simple-circuit/minict/README.md

# minict

This repository is an archive for the N7VK Mini Curve Tracer source code. For the original version, two key components, the C8051F121-GQ micro and the DPL-USB1232H serial to USB converter are still available. However, newer processors such as the Raspberry Pi Pico2 can reduce the cost considerably with only a slight decrease in analog performance.

The pico_ct folder contains a design upgrade using the Pico2 processor. Instead of a single double sided PC board, the design has been split to two boards. Each board can be CNC milled on a single sided copper clad board. Build informaton is contained in the picoCT board build pdf document.
This is an advanced project.

.
The new curve tracer assembly.

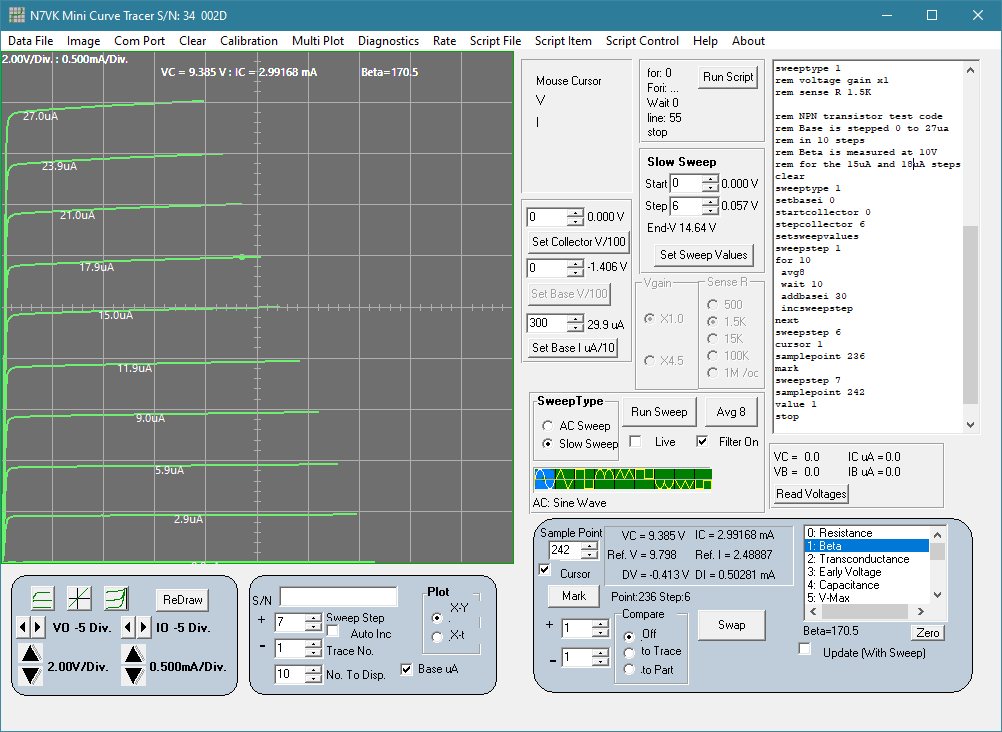
[picture p1: beta.png]
.
Curves for a 2N2222A transistor.

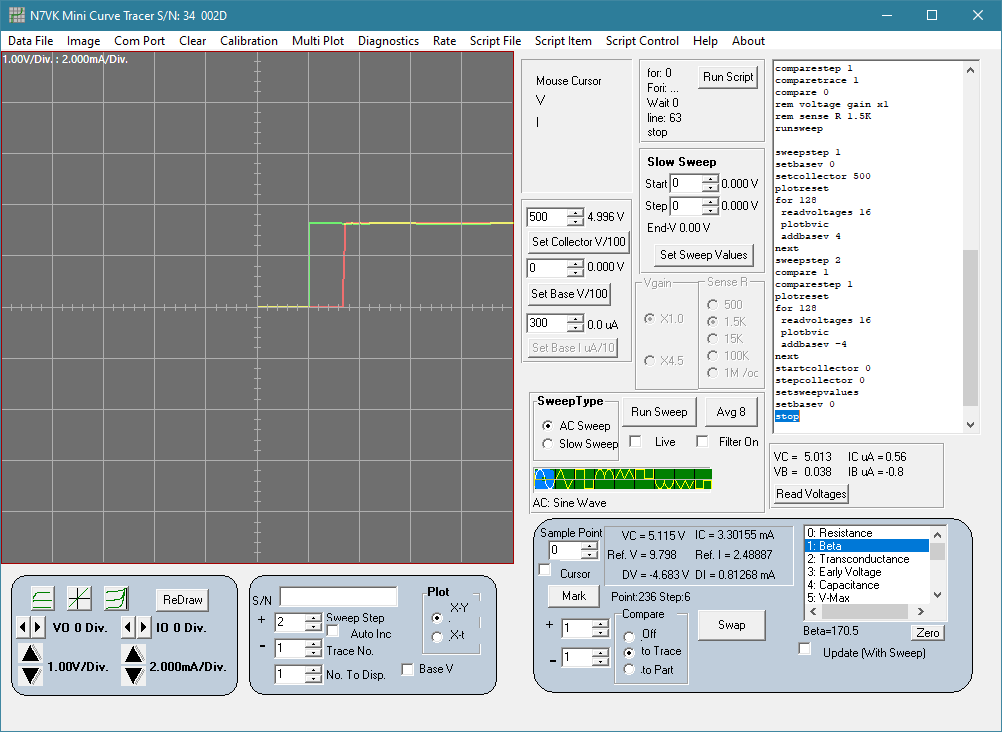
[picture p2: relay.png]
.
Hysteresis traces for a DIP relay.

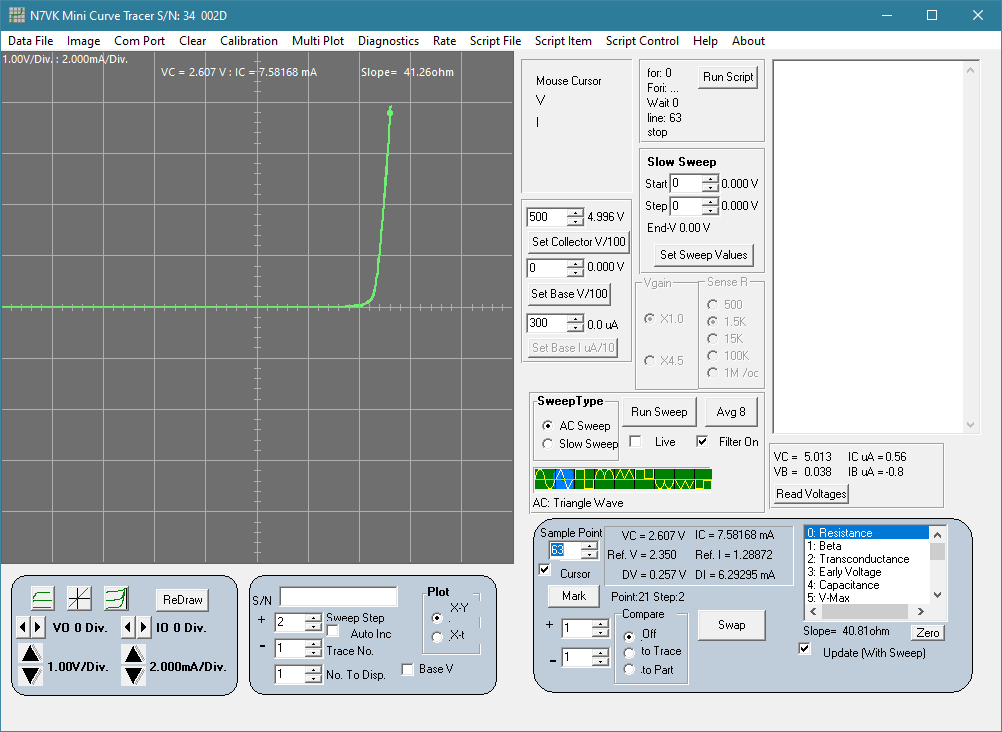
[picture p3: led.png]
.
Measuring an LED turn on voltage and series resistance.

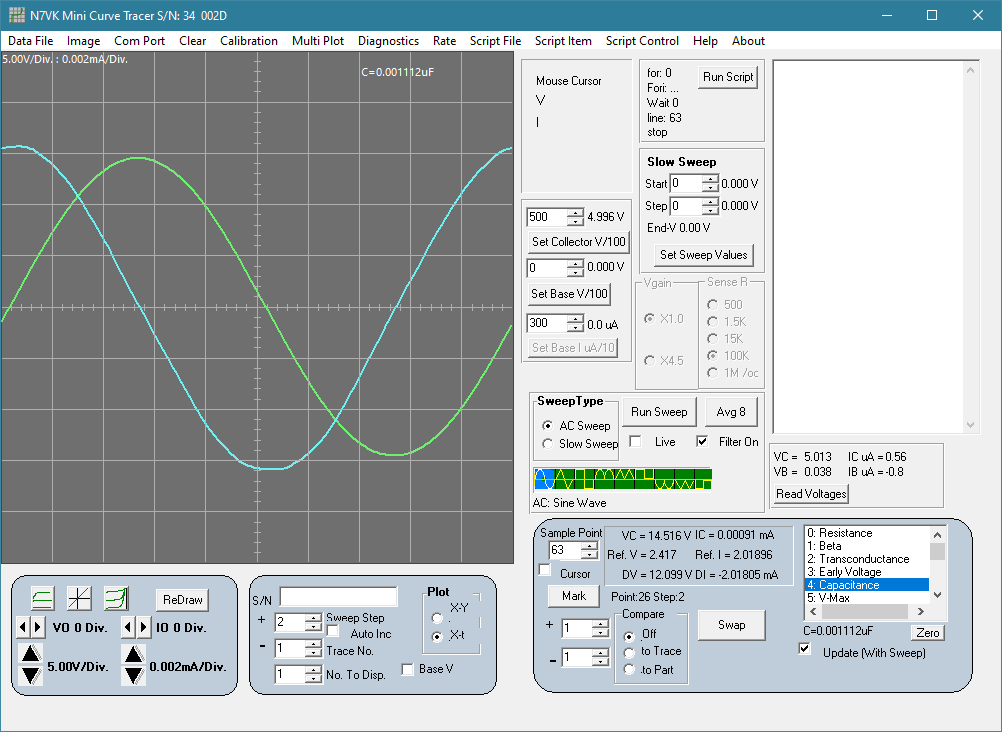
[picture p4: capacitor.png]
.
Capacitor measurement showing the current and voltage plots over time.
