simple-circuit/minict/pico_ct/readme first.pdf

# MiniCT

Three compiled version of the curve tracer application are available.

pico2_ct.exe is the Windows 64 verson

miniCT_PI_32 is the Raspberry Pi 32 bit-version

miniCT_PI_64 is the Raspberry Pi 64 bit-version

When running the Windows version, an error message may be displayed. This usually occurs when the curve tracer is not plugged into the USB port. Just click Ok to continue.

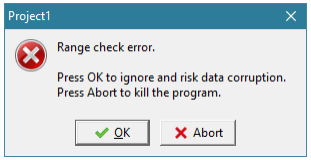
[picture p5: figure]

When the Raspberry Pi Linux executable file is copied, check the file properties and set Execute to Anyone.

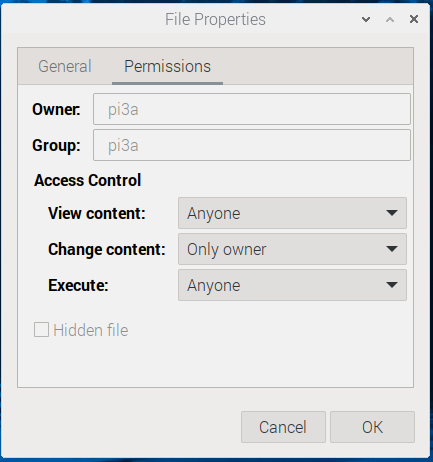
[picture p6: figure]

Double click on the file and select execute.

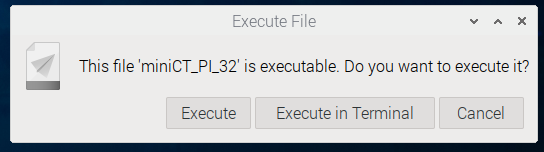
[picture p7: figure]

The program may also give an error message. This is more common in the 32-bit version. It is related to a search for an active curve tracer on the USB ports. Just click Ok.

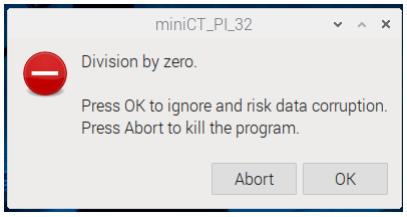
[picture p8: figure]

For Windows and Linux click on Calibrate then Load Cal to read in the calibration constants. You will need to perform a calibration procedure on your curve tracer for the most accurate measurements.

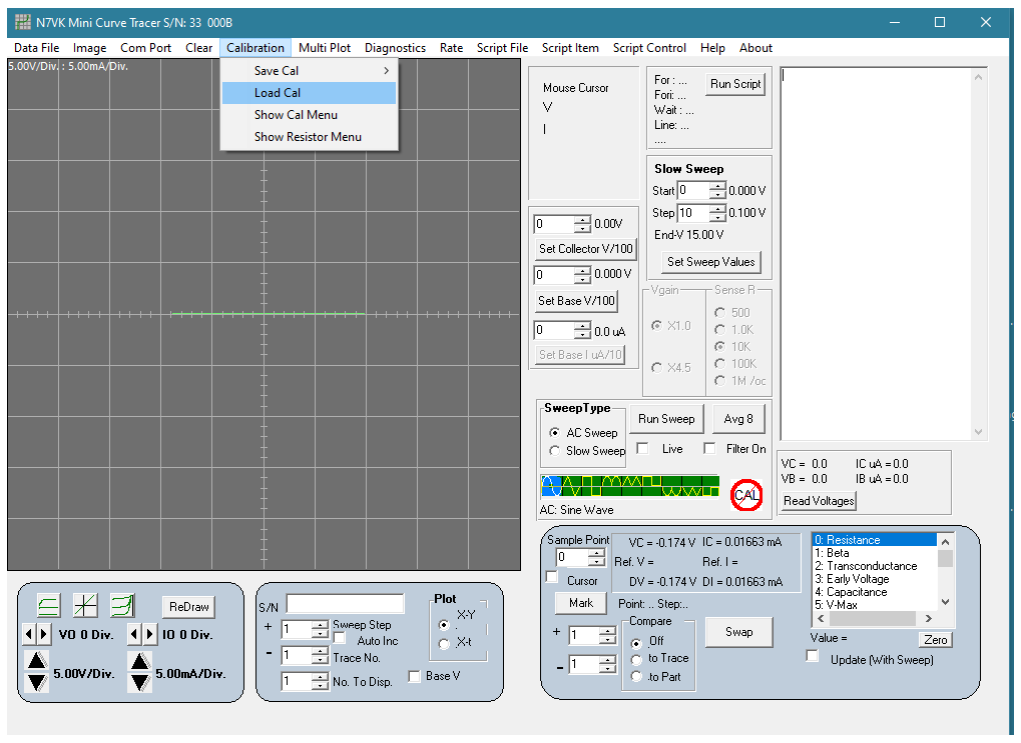
[picture p9: figure]
