simple-circuit/minict/Pascal_Code/Examples/2N2222AS.bmp

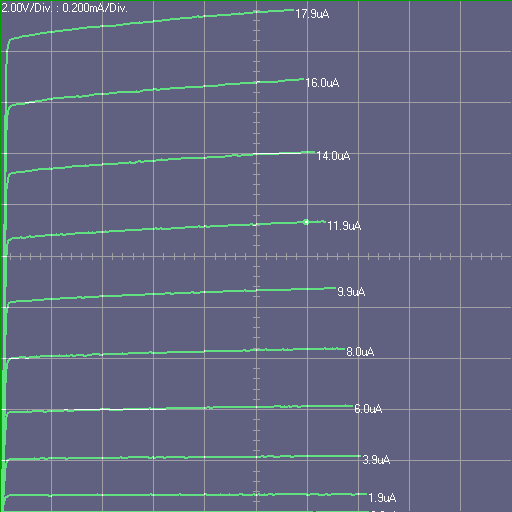
Pascal_Code/Examples/2N2222AS.bmp
