simple-circuit/minict/Pascal_Code/Examples/cap.bmp

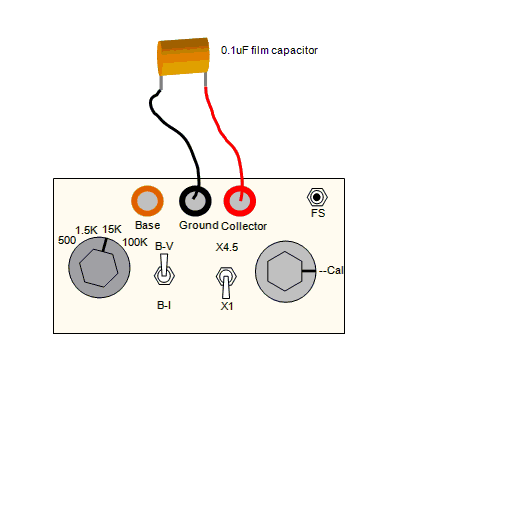
Pascal_Code/Examples/cap.bmp
