simple-circuit/minict/Pascal_Code/Examples/dcmotor.bmp

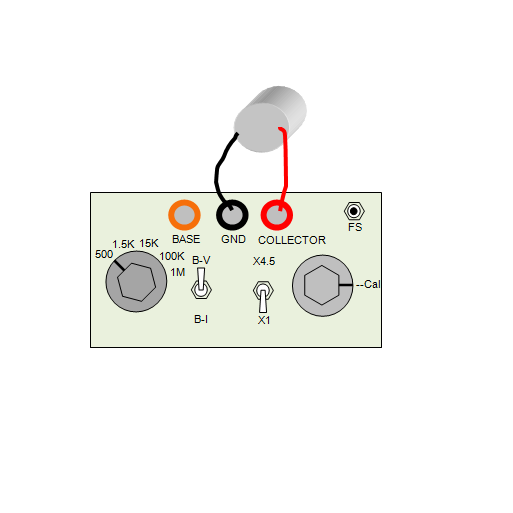
Pascal_Code/Examples/dcmotor.bmp
