simple-circuit/minict/Pascal_Code/Examples/jfet.bmp

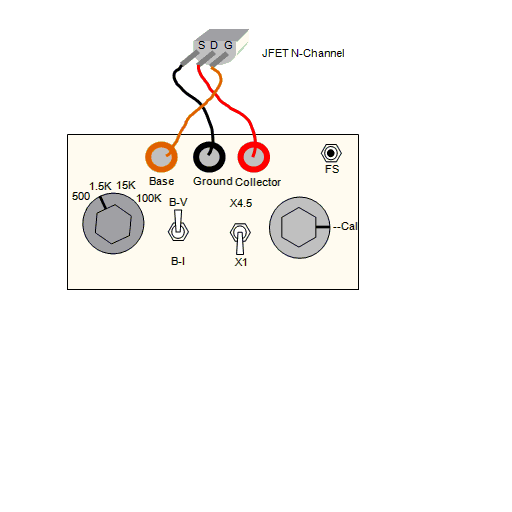
Pascal_Code/Examples/jfet.bmp
