simple-circuit/minict/Pascal_Code/Examples/logic.bmp

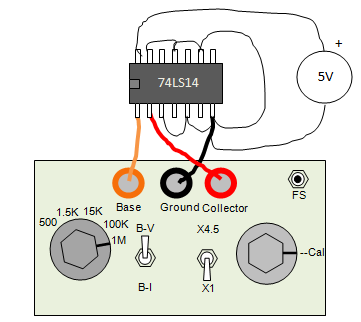
Pascal_Code/Examples/logic.bmp
