simple-circuit/minict/Pascal_Code/Examples/mosfet.bmp

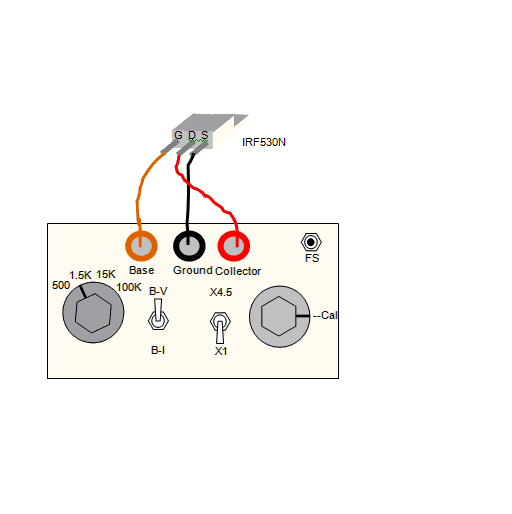
Pascal_Code/Examples/mosfet.bmp
