simple-circuit/minict/Pascal_Code/Examples/parallel_cap.bmp

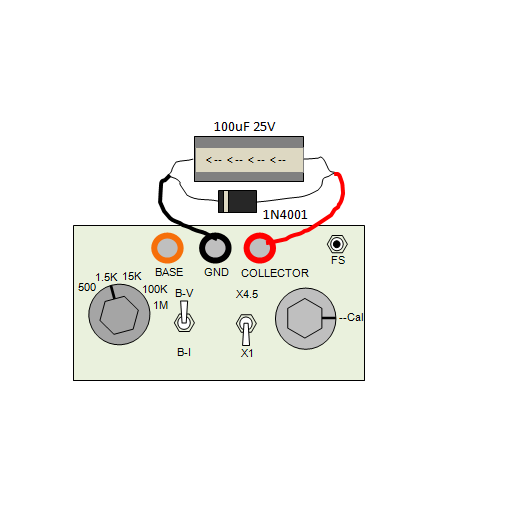
Pascal_Code/Examples/parallel_cap.bmp
