simple-circuit/minict/Pascal_Code/Examples/parallel_cap.png

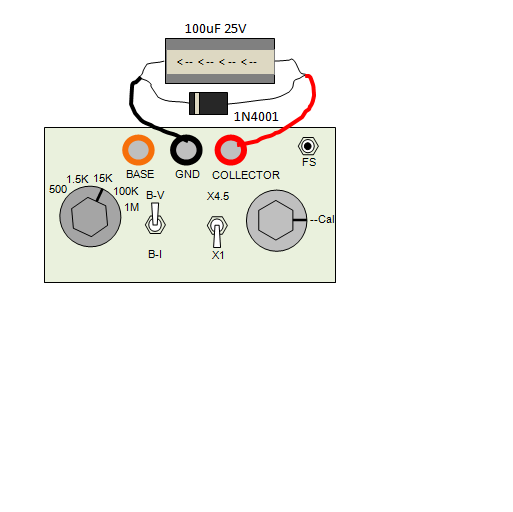
Pascal_Code/Examples/parallel_cap.png
