simple-circuit/minict/Pascal_Code/Examples/relay.bmp

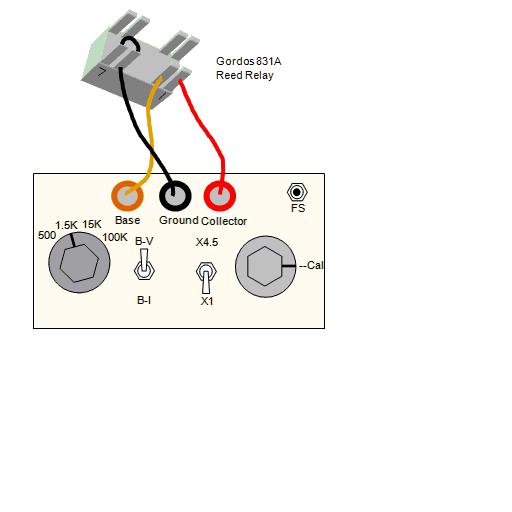
Pascal_Code/Examples/relay.bmp
