simple-circuit/minict/Pascal_Code/Examples/threhold74ls14.bmp

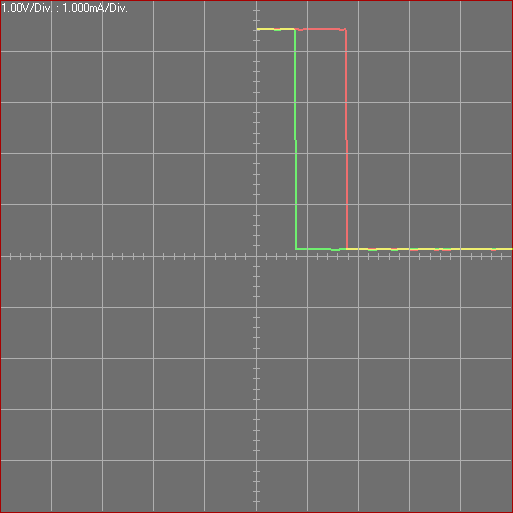
Pascal_Code/Examples/threhold74ls14.bmp
