simple-circuit/minict/Pascal_Code/traces/1N914r.bmp

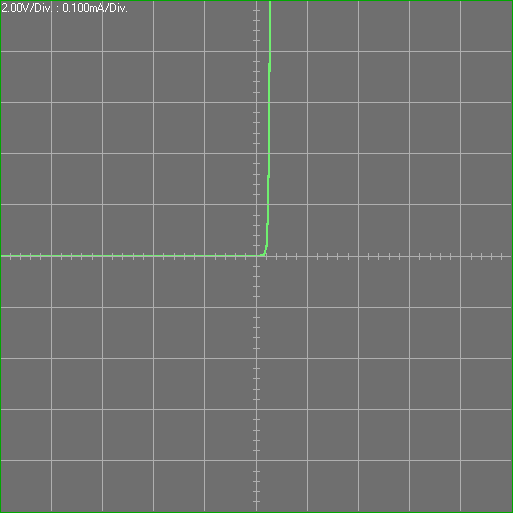
Pascal_Code/traces/1N914r.bmp
