simple-circuit/minict/Pascal_Code/traces/74HC14_vcc_input_to gnd.bmp

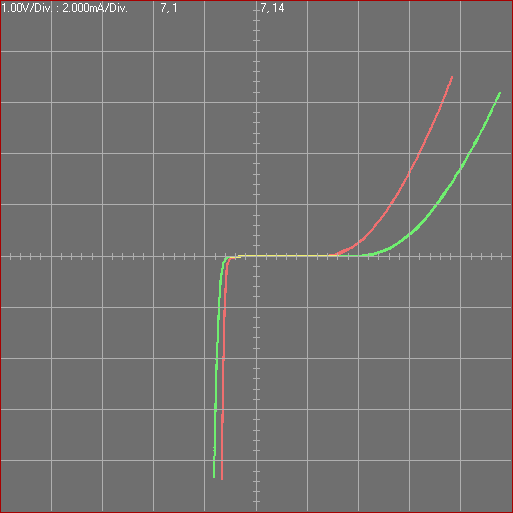
Pascal_Code/traces/74HC14_vcc_input_to gnd.bmp
