simple-circuit/minict/Pascal_Code/traces/74HC14_vcc_input_to gnd_p.bmp

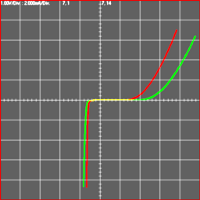
Pascal_Code/traces/74HC14_vcc_input_to gnd_p.bmp
