simple-circuit/minict/Pascal_Code/traces/74LS00_input_to_Vcc.bmp

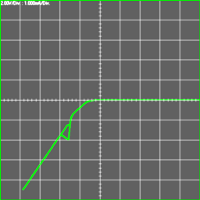
Pascal_Code/traces/74LS00_input_to_Vcc.bmp
