simple-circuit/minict/Pascal_Code/traces/capacitor.bmp

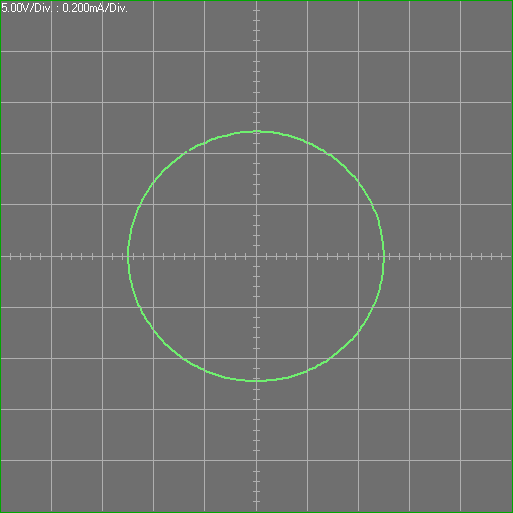
Pascal_Code/traces/capacitor.bmp
