simple-circuit/minict/Pascal_Code/traces/EBnpn.bmp

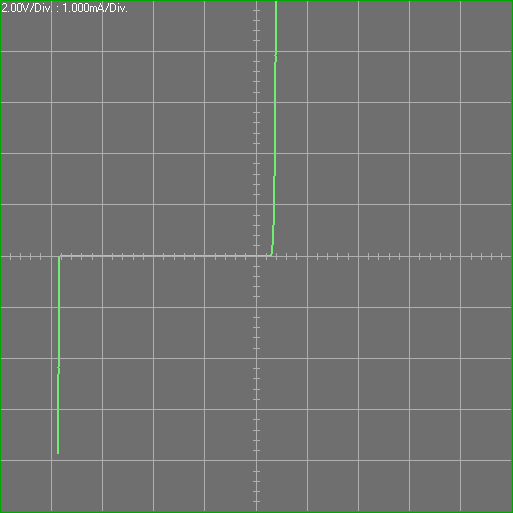
Pascal_Code/traces/EBnpn.bmp
