simple-circuit/minict/Pascal_Code/traces/GDpch.bmp

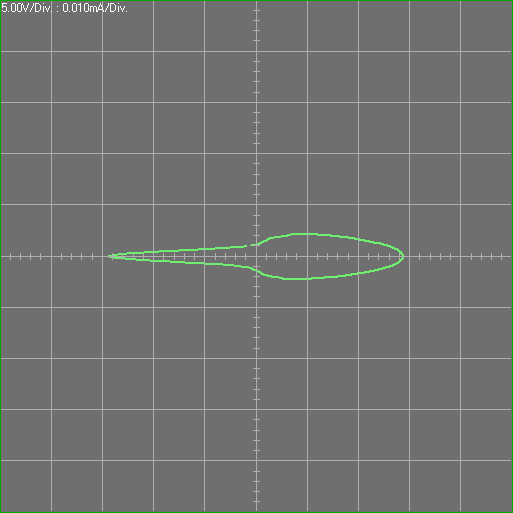
Pascal_Code/traces/GDpch.bmp
