simple-circuit/minict/Pascal_Code/traces/gordos_relay.bmp

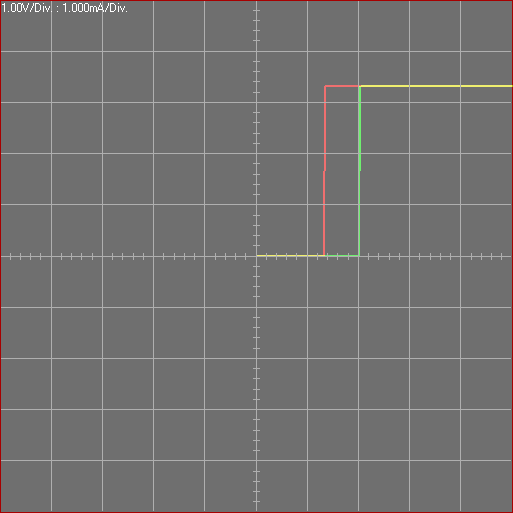
Pascal_Code/traces/gordos_relay.bmp
