simple-circuit/minict/Pascal_Code/traces/leakycap.bmp

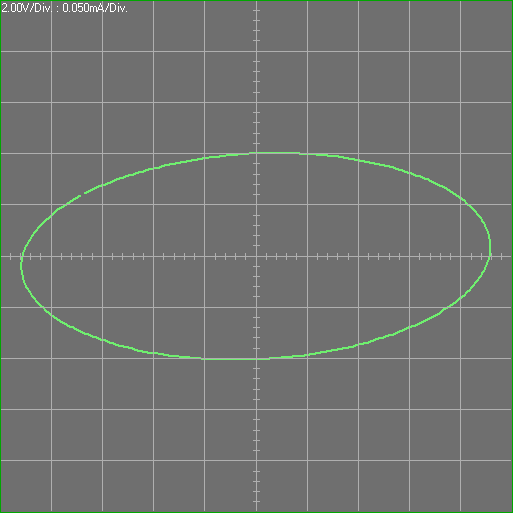
Pascal_Code/traces/leakycap.bmp
