simple-circuit/minict/Pascal_Code/traces/LF356_Vcc_Gnd.bmp

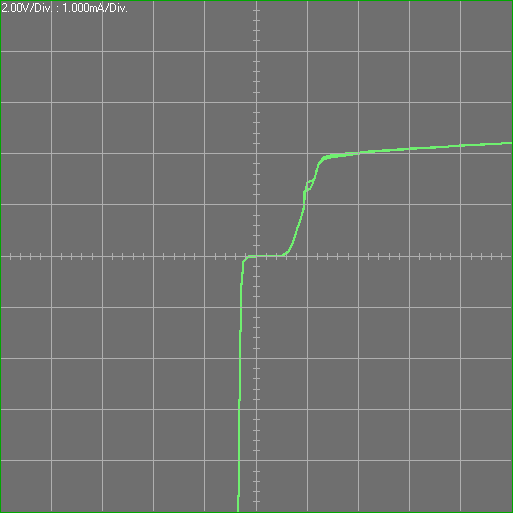
Pascal_Code/traces/LF356_Vcc_Gnd.bmp
