simple-circuit/minict/Pascal_Code/traces/NeedleSi.bmp

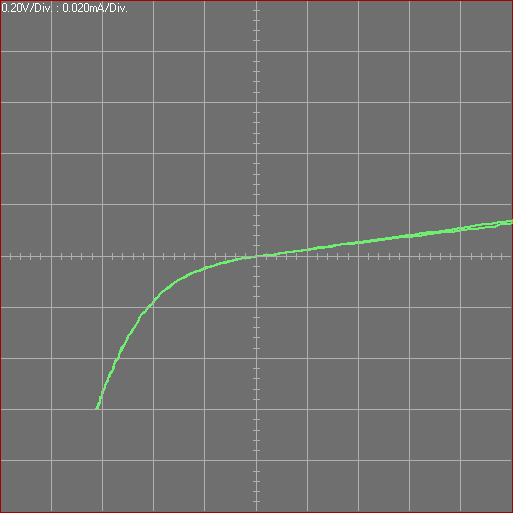
Pascal_Code/traces/NeedleSi.bmp
