simple-circuit/minict/Pascal_Code/traces/RC.bmp

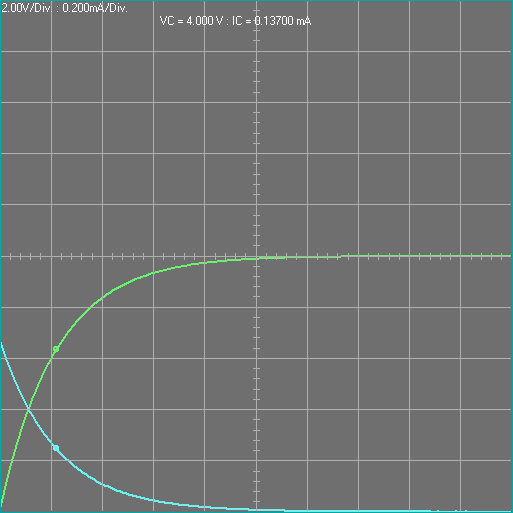
Pascal_Code/traces/RC.bmp
