simple-circuit/minict/Pascal_Code/traces/resistor.bmp

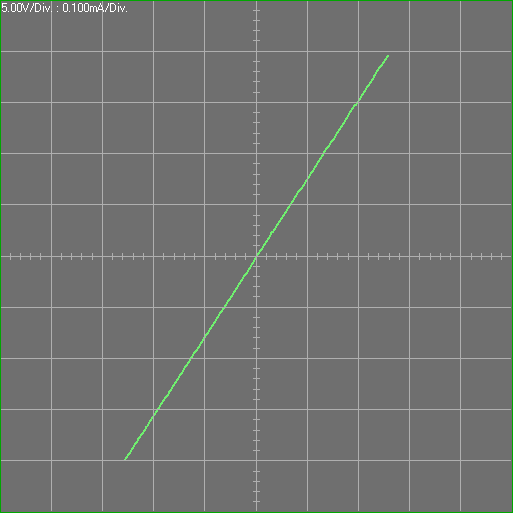
Pascal_Code/traces/resistor.bmp
