simple-circuit/minict/Pascal_Code/traces/SDmulti.bmp

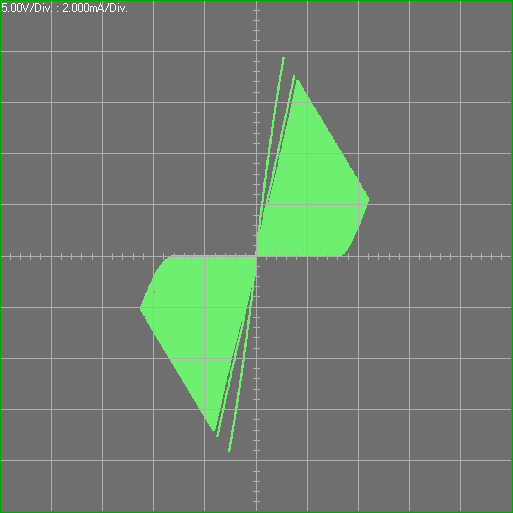
Pascal_Code/traces/SDmulti.bmp
