simple-circuit/minict/Pascal_Code/traces/SDsingle2.bmp

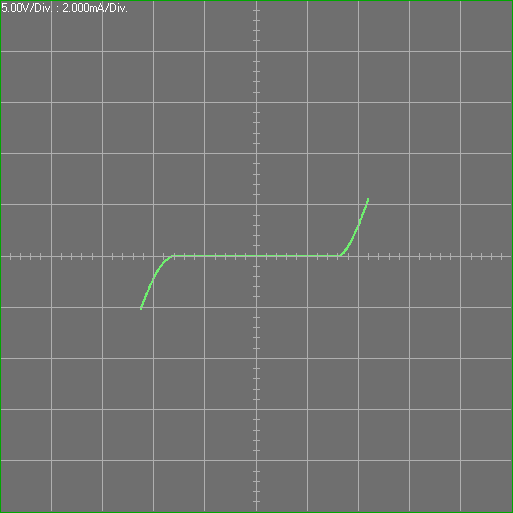
Pascal_Code/traces/SDsingle2.bmp
