simple-circuit/minict/Pascal_Code/traces/SGpch.bmp

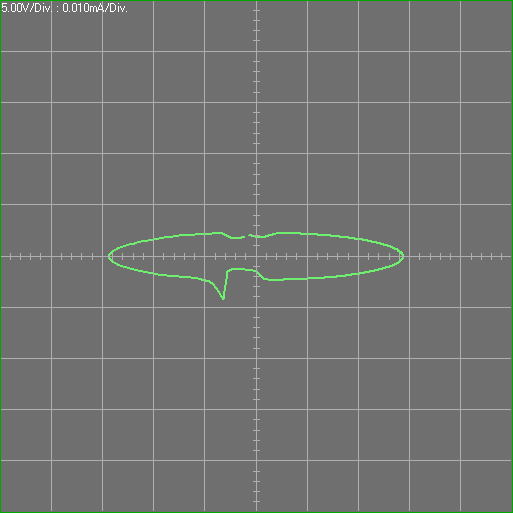
Pascal_Code/traces/SGpch.bmp
