simple-circuit/minict/Pascal_Code/traces/TinOxide.bmp

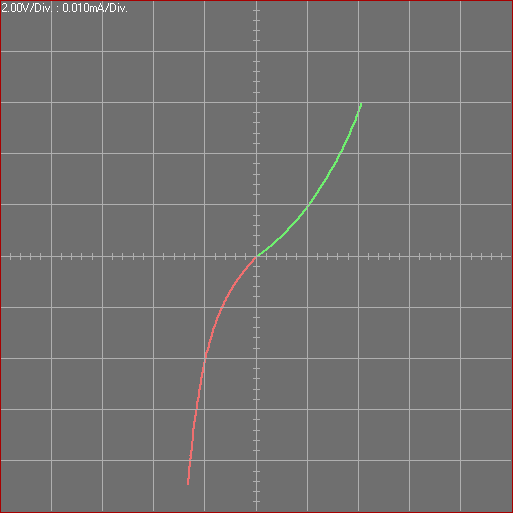
Pascal_Code/traces/TinOxide.bmp
