simple-circuit/minict/pico_ct/analog_schematic.png

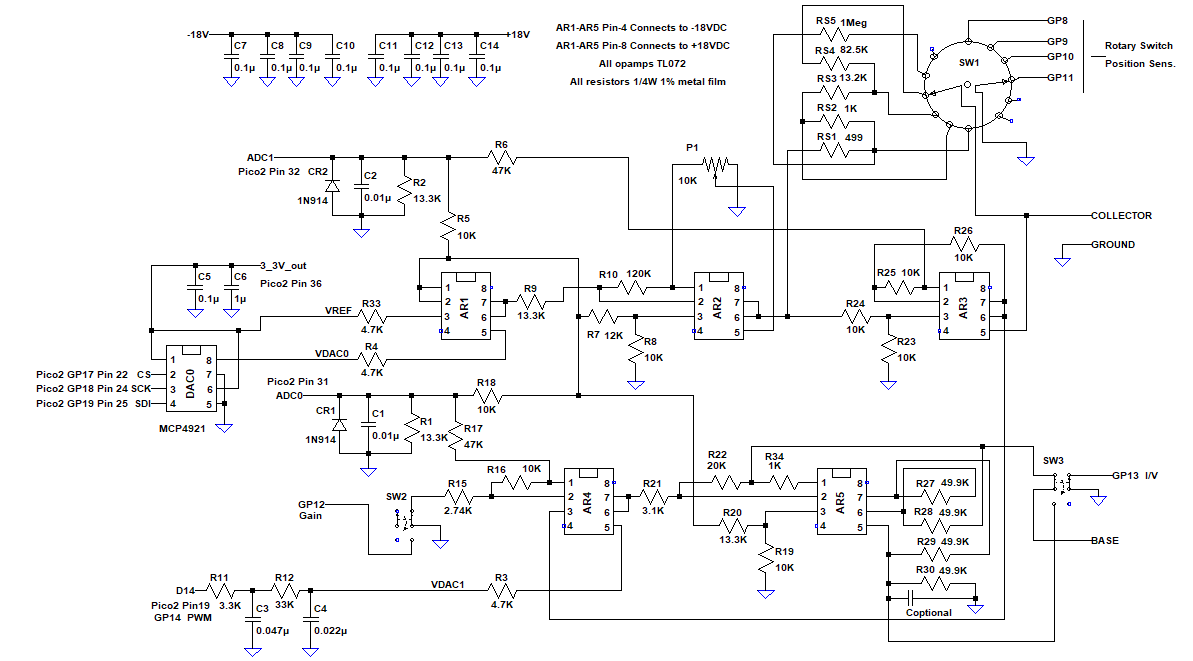
pico_ct/analog_schematic.png
