simple-circuit/minict/pico_ct/digital_schematic.png

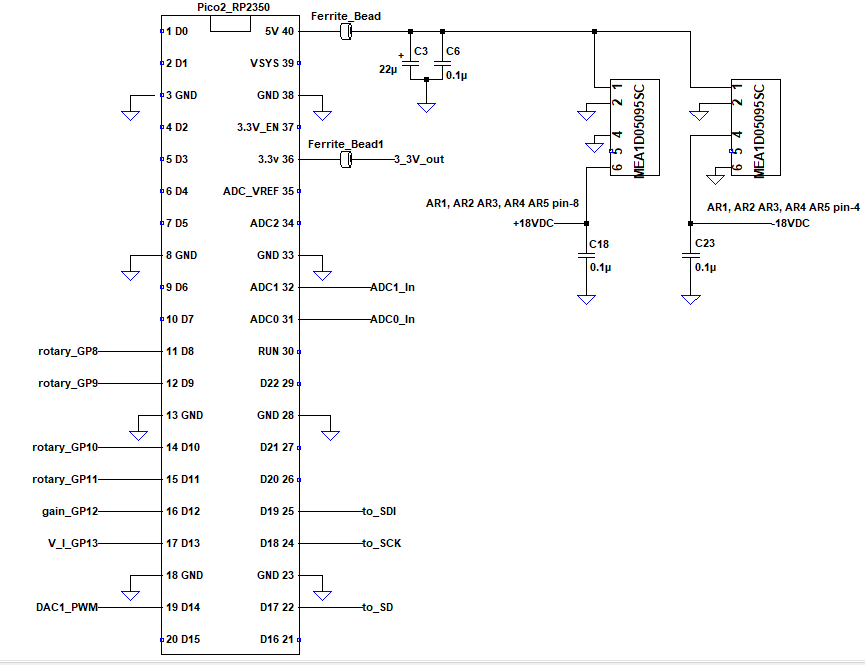
pico_ct/digital_schematic.png
