simple-circuit/minict/pico_ct/MiniCT_lazarus_pi3_pc/RCtc.bmp

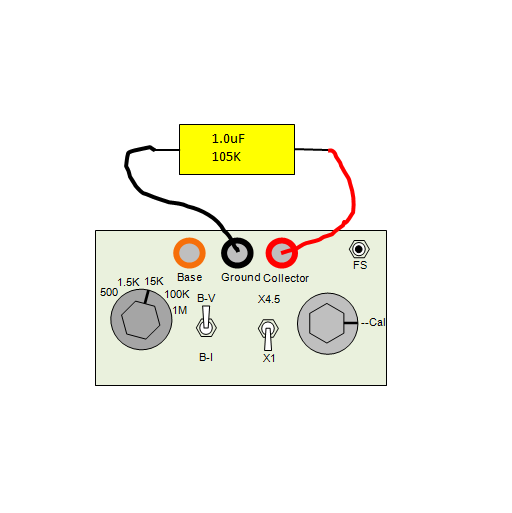
pico_ct/MiniCT_lazarus_pi3_pc/RCtc.bmp
