simple-circuit/minict/pico_ct/MiniCT_lazarus_pi3_pc/vmcall.bmp

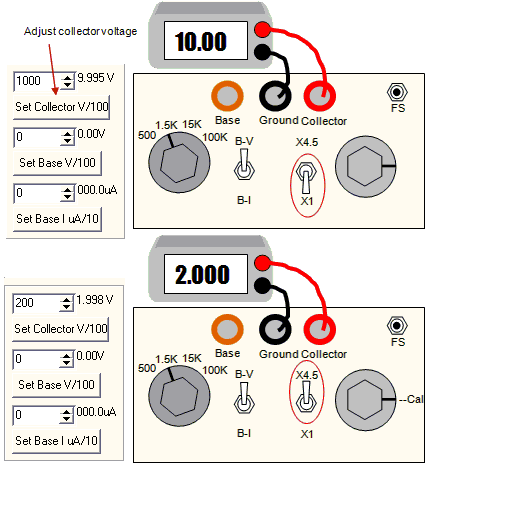
pico_ct/MiniCT_lazarus_pi3_pc/vmcall.bmp
