simple-circuit/minict/pico_ct/MiniCT_lazarus_pi3_pc_hlp/HTML_Help/display.png

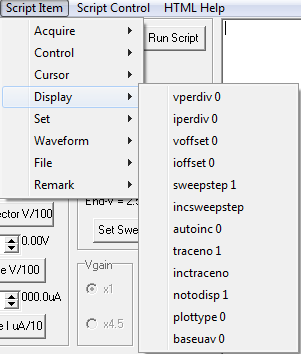
pico_ct/MiniCT_lazarus_pi3_pc_hlp/HTML_Help/display.png
