simple-circuit/minict/(list of files, cad)

Other CAD files:
C_code/mini_ct.obj
