simple-circuit/minict/pico_ct/build.png

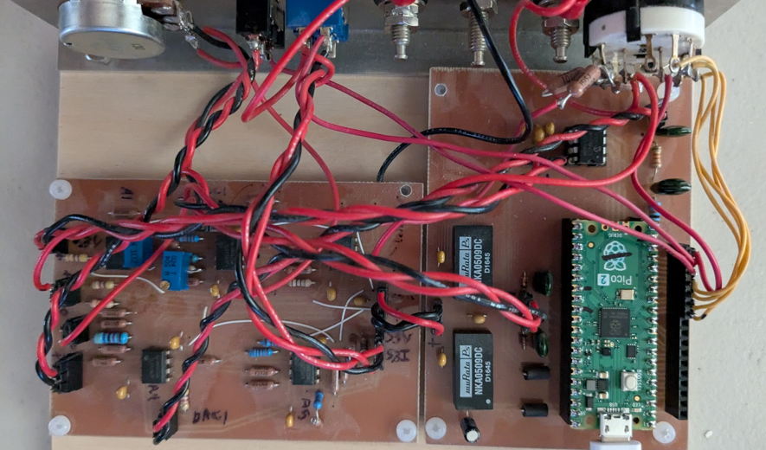
pico_ct/build.png
